jeffbebe/Plantie/hardware/esp_arduino_i2c/linkl.txt

https://www.electronicwings.com/nodemcu/nodemcu-i2c-with-arduino-ide
