jeffbebe/Plantie/text/it/Plantie™.pptx

## Plantie™

Authors:
Kamil Choiński
Oskar Stabla

## About our project

- Designed for lazy, but protective people
- Remote control of a plant and it’s environment
- Focused on learning arduino-esp communication as well as creating a website from scratch

## Used technologies

- HTML
- JavaScript
- Node.js
- Bootstrap
- Charts.js
- Axios
- Font Awsome
- SqLite
- Arduino IDE

## Functionality

- Monitoring environment and soil parameters (Humidity, moisture, temperature, brightness)
- Sending commands to arduino (eg. watering plant)
- Saving data to database
- Data visualisation(chart)
- Easily possible improvements

## Work preview

## Thanks for attention
