jeffbebe/Plantie/text/it/harmonogram początkowy/harmonogram_ang.tex

\documentclass{article}
\usepackage{geometry}
\newgeometry{tmargin=3cm, bmargin=3cm}
\begin{document}

\title{Plantie™}
\author{Kamil Choiński, Oskar Stabla}
\maketitle

\tableofcontents

\section{Wstep, Cel i zakres projektu}
Project goal is to create a website to remotely manage microcontroller using Wi-Fi network and ESP8266 module. A user will be able to water the plant monitor the plant's soil.
\addcontentsline{toc}{section}{Unnumbered Section}
\section{Project functionalities}
2-way communication between ESP8266 and the website. Data visualization. Remote watering and fertilizating the soil. Turning the light on and off.
\section{Schedule}
\subsection{Week 1}
Creating site sketch in HTML
\subsection{Week 2}
Creating CSS styles
\subsection{Week 3}
Getting acquainted with Node.js technology
\subsection{Week 4}
Setting up page on a server 
\subsection{Week 5, 6}
Implementing our 2-way communication system
\subsection{Week 7, 8}
Final technical and visual modifications. Tests

\section{Technologies planned to use}
HTML, CSS, JavaScript, Node.js, C, LaTeX

\end{document}
