jeffbebe/Plantie/text/sm/harmonogram początkowy/streszczenie_raportu_sm.pdf

## PlantieTM

Kamil Choiński, Oskar Stabla

16 grudnia 2019

## 1 Opis projektu

Nasza koncepcja opiera się na systemie zdalnego zarządzania rośliną. Chcemy mierzyć parametry gleby i otoczenia takie jak wilgotność, nasłonecznienie. W zależności od odczytanych wartości przez płytkę rozwojową UNO połączoną z modułem ESP8266 będzie możliwe sterowanie pompką wody, lampą. Mamy zamiar połączyć projekt z IT, dlatego panel sterowania będzie umieszczony na stronie internetowej.

## 2 Cel

Nasz projekt ma na celu pomoc zabieganym ludziom, którzy nie mają czasu na zajmowanie się swoją ukochaną roślinką przez swój częsty brak pobytu w domu. Wystarczy dostęp do internetu, nic więcej.

## 3 Harmonogram

3.1 4.11

Przeanalizowanie schematów płytki rozwojowej UNO, modułu komunikacyjnego ESP8266, czujnika wilgotności gleby, czujnika wilgotności powietrza, czujnika nasłonecznienia oraz rozwiązanie techniczne doświetlania rośliny. Stworzenie schematu elektrycznego gotowego projektu. Testowanie poprawności działania posiadanych czujników w warunkach domowych. Implementacja komunikacji z modułem ESP8266. Dopasowywanie czasów działania. Dokupienie brakujących komponentów gotowego projektu.

3.2 25.11

Realizacja połączeń elektrycznych na płytce stykowej i ostateczne testowanie poprawności działania. Przeniesienie projektu na płytkę uniwersalną. Przygotowanie ewentualnej obudowy i realizacja montażu systemu doświetlania. Stworzenie prezentacji na zajęcia

3.3 16.12

Wstępna prezentacja gotowego projektu i ocena błędów.

1

3.4 20.01

Ostateczna prezentacja z poprawką błędów.

## 4 Kosztorys

Suma: 58 PLN
Płytka rozwojowa UNO - 10 PLN Moduł ESP8266 - 18 PLN
Czujnik wilgotności powietrza 5 PLN Czujnik wilgotności gleby 5 PLN Czujnik nasłonecznienia 5 PLN
Przetwornik 5 PLN
Żarówka 5 PLN
Kabelki, płytka uniwersalna, cyna, klej na gorąco - 10 PLN

## 5 Podział obowiązków

Kamil Choiński -50%, Oskar Stabla - 50%

## 6 Przykładowe rozwiazania

### 6.1 System zarządzania szklarnią

Nasze rozwiązanie zarządza tylko jedną rośliną, lecz jest łatwiejsze w obsłudze i dużo tańsze, gdyż
nie opiera się na sterowniku PLC. Zdjęcie przykładu: https://gyazo.com/5376f09df2c0a7b5555e8406506f67bb

## 7 Schemat blokowy

Przedstawiony na stronie 3.

2


3
