jeffbebe/Plantie/hardware/esp_arduino_i2c/4bf64ac7b4bd08442e286d082e429457.png

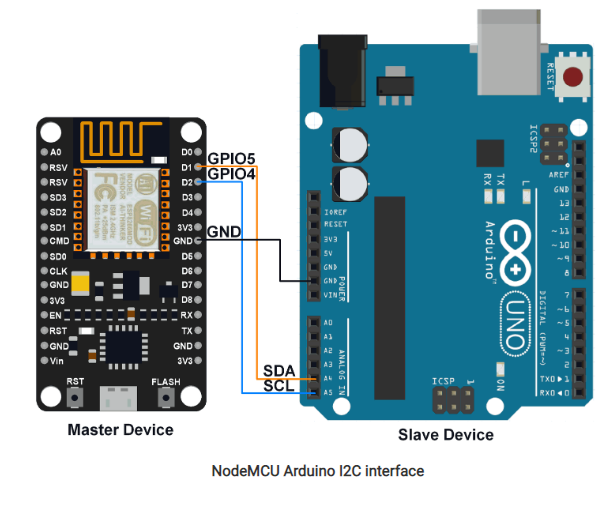
hardware/esp_arduino_i2c/4bf64ac7b4bd08442e286d082e429457.png
