jeffbebe/Plantie/server/views/img/images.jpg

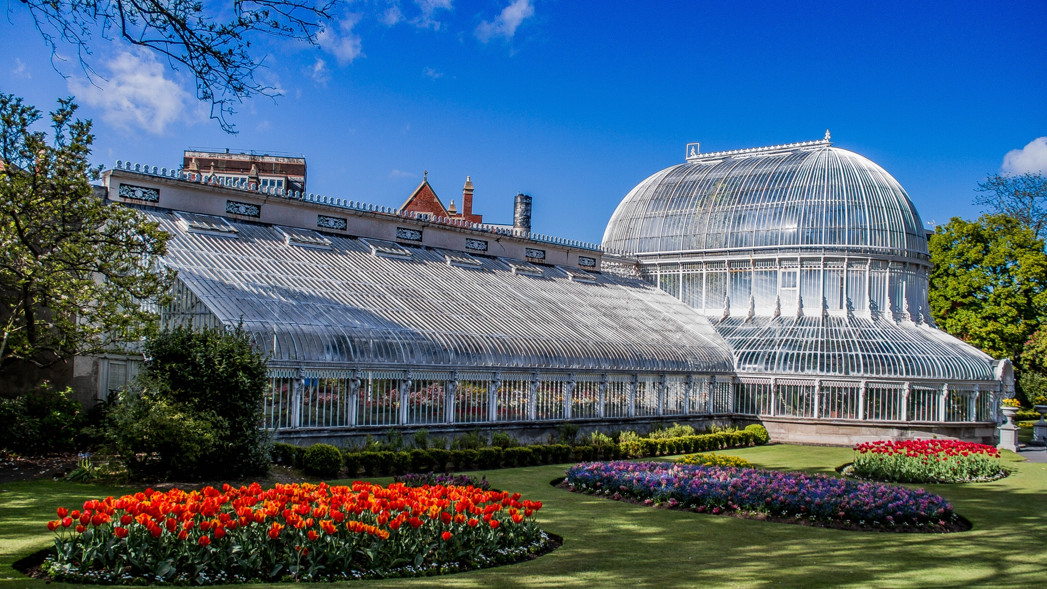
server/views/img/images.jpg
