jeffbebe/Plantie/server/views/img/leaf_background.jpg

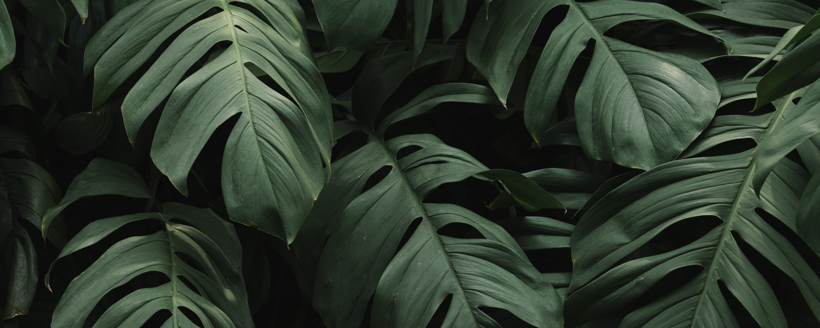
server/views/img/leaf_background.jpg
