jeffbebe/Plantie/text/sm/raport 1/Figures/polsl_logo2_zn_en.pdf

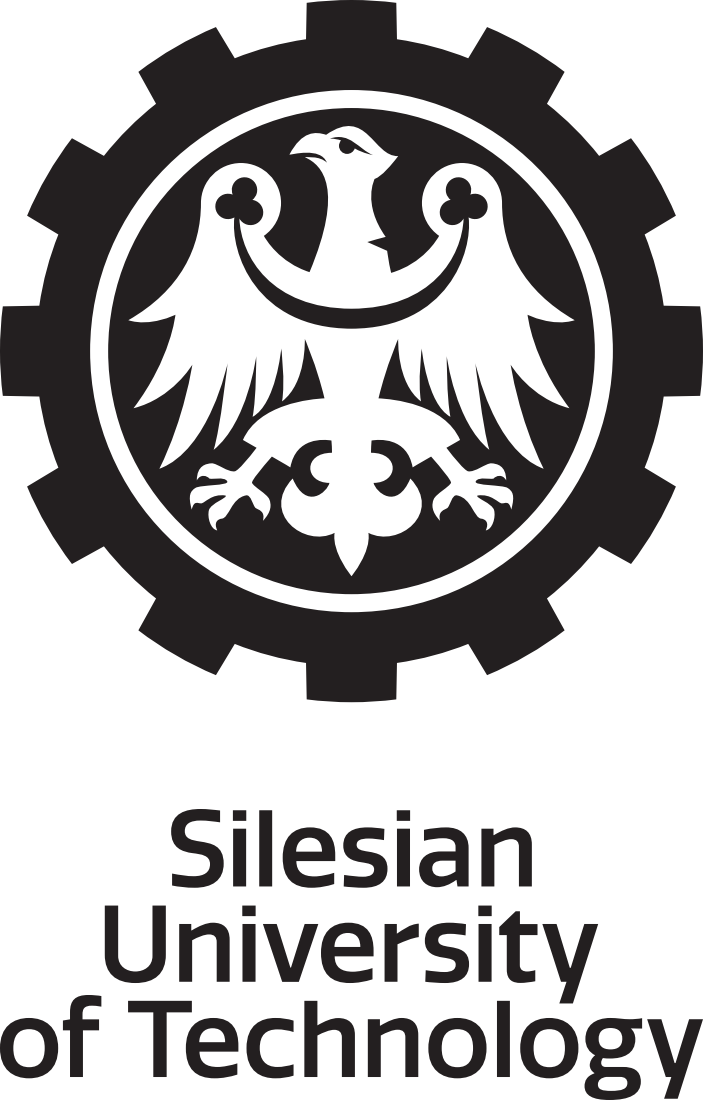
[picture p27: page 1]
