jeffbebe/Plantie/hardware/ESP12E-ARDUINO-SERIAL-COMMUNICATION/SERIAL_SERIAL_ESP/SERIAL_SERIAL_ESP.ino

void setup() {
  // Open serial communications and wait for port to open:
  Serial.begin(115200);
  while (!Serial) {
    ; // wait for serial port to connect. Needed for native USB port only
  }
}

void loop() { // run over and over
  if (Serial.available()) {
    Serial.write(Serial.read());
  }
}
