jeffbebe/Plantie/hardware/esp_web_tcp/esp_tcp/esp_tcp.ino

/*
 * TCP/IP communication ESP8266WiFi
 * Copyright (C) 2017 http://www.projetsdiy.fr - https://www.diyprojects.io
 * 
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
 * You should have received a copy of the GNU General Public License
 * along with this program.  If not, see <http://www.gnu.org/licenses/>.
 */
#include <ESP8266WiFi.h>
const char* ssid     = "Internet";      // SSID
const char* password = "dlink123";      // Password
const char* host = "192.168.1.4";  // IP serveur - Server IP
const int   port = 8080;            // Port serveur - Server Port
const int   watchdog = 5000;        // Fréquence du watchdog - Watchdog frequency
unsigned long previousMillis = millis(); 

void setup() {
  Serial.begin(115200);
  Serial.print("Connecting to ");
  Serial.println(ssid);
  
  WiFi.begin(ssid, password);
  while (WiFi.status() != WL_CONNECTED) {
    delay(500);
    Serial.print(".");
  }

  Serial.println("");
  Serial.println("WiFi connected");  
  Serial.println("IP address: ");
  Serial.println(WiFi.localIP());
}

void loop() {
  unsigned long currentMillis = millis();

  if ( currentMillis - previousMillis > watchdog ) {
    previousMillis = currentMillis;
    WiFiClient client;
  
    if (!client.connect(host, port)) {
      Serial.println("connection failed");
      return;
    }

    String url = "/watchdog?command=watchdog&uptime=";
    url += String(millis());
    url += "&ip=";
    url += WiFi.localIP().toString();
    
    // Envoi la requete au serveur - This will send the request to the server
    client.print(String("GET ") + url + " HTTP/1.1\r\n" +
               "Host: " + host + "\r\n" + 
               "Connection: close\r\n\r\n");
    unsigned long timeout = millis();
    while (client.available() == 0) {
      if (millis() - timeout > 5000) {
        Serial.println(">>> Client Timeout !");
        client.stop();
        return;
      }
    }
  
    // Read all the lines of the reply from server and print them to Serial
    while(client.available()){
      String line = client.readStringUntil('\r');
      Serial.print(line);
    }
  }
}
