jeffbebe/Plantie/(commit log)

2019-10-27 Arduino + esp code start
2019-10-29 Responsive nav-buttons, logo clik - back to home
2019-11-02 Added a single button, able to push data into database
2019-11-18 Arduino/Esp - Server - working (kinda)
2019-11-24 Test code to light led and read sensor. Reports
2019-11-24 Revert "Test code to light led and read sensor. Reports"
    This reverts commit 6d1e4d74849aaa83b3e45f9a5d75c1fb28cb20d1.
    [Arduino_I2C_slave.ino, Arduino_SPI_Slave.ino, MEGA_CODE.ino, NodeMCU_I2C_master.ino, SERIAL_SERIAL_ESP.ino, UNO.ino, UNO_with_temp_sensor.ino]
2019-11-24 Add test code to turn on led, read sensor data.
2019-12-01 Arduino display configuration
2019-12-27 Frames, buttons sizing, deleted chart animations
2020-01-06 Arduino code update 06.01
2020-01-11 It report update - switched to latex
